varshaansh-git/Team-ReFlex/dp_assm/FINAL_ASSEMBLY.SLDASM

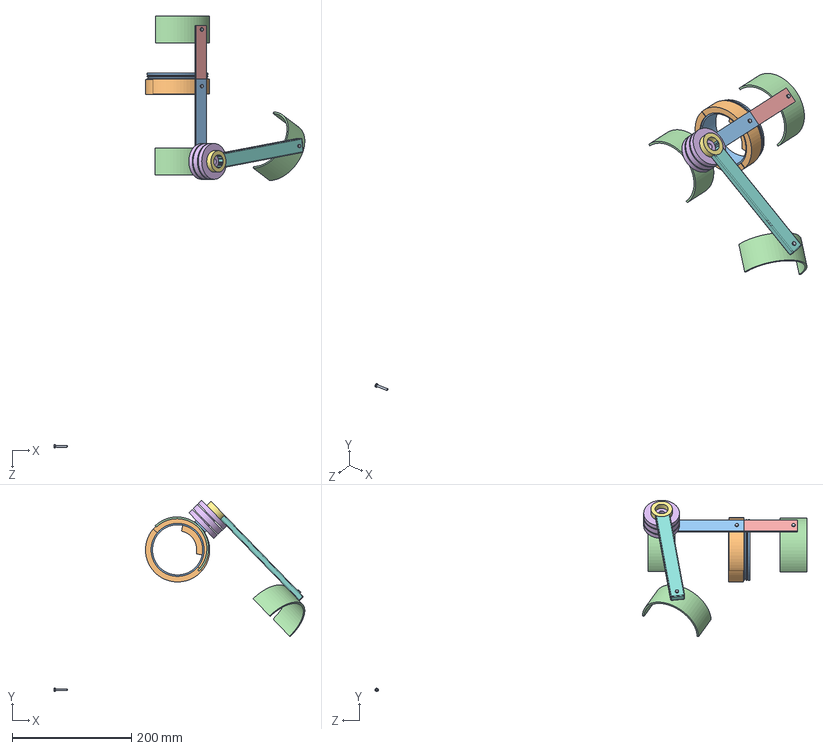
[picture p1: CAD file, 2026-10-25]
dp_assm/FINAL_ASSEMBLY.SLDASM
419.7 x 320.7 x 723.5 mm
inner ring-1 x 2
outer blue ring-1 x 2
rectangle to attach cuff
cuff x 3
rectangle
pulley
005_Fixed elbow bearing housing 1
004_Upper arm lateral rail 1
hex bolt gradeab_iso x 4
cuff2
