varshaansh-git/Team-ReFlex/dp_assm/pulley.SLDPRT

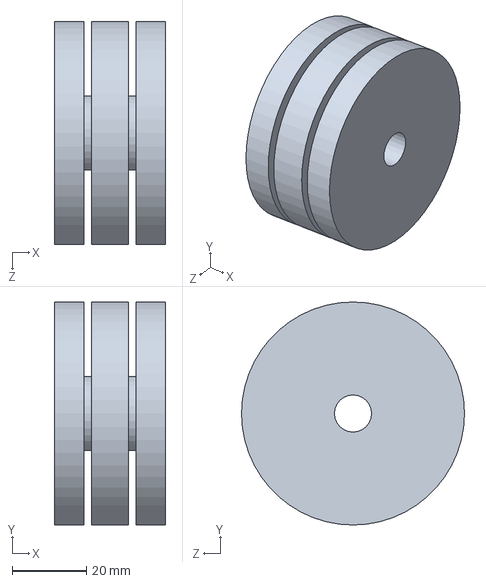
[picture p2: CAD file, 2026-10-25]
dp_assm/pulley.SLDPRT
30.0 x 60.0 x 60.0 mm
