varshaansh-git/Team-ReFlex/dp_assm/rectangle.SLDPRT

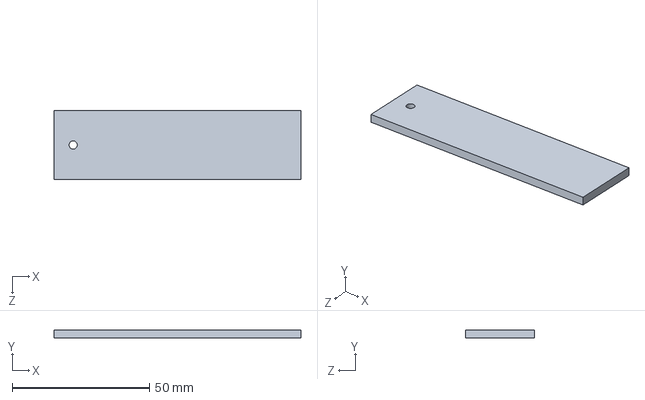
[picture p3: CAD file, 2026-10-25]
dp_assm/rectangle.SLDPRT
90.0 x 3.00 x 25.0 mm
