varshaansh-git/Team-ReFlex/dp_assm/Part1-1.SLDPRT

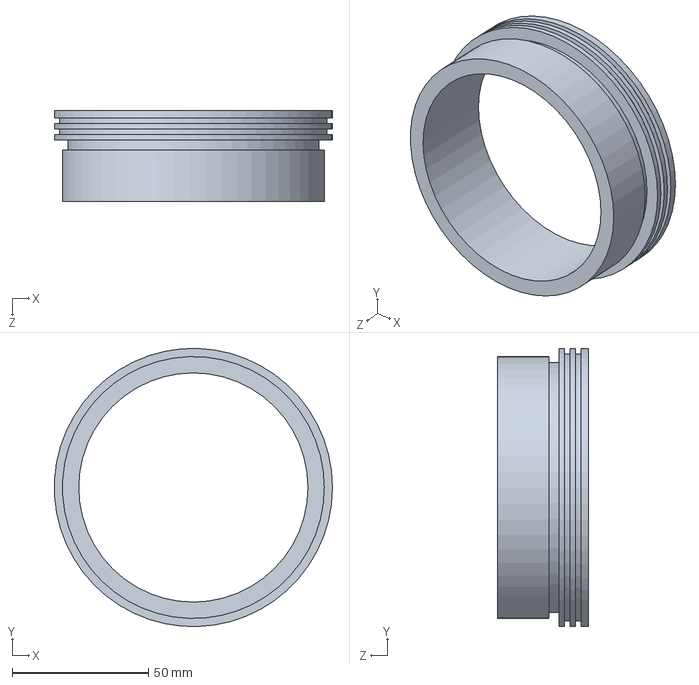
[picture p4: CAD file, 2026-10-25]
dp_assm/Part1-1.SLDPRT
101.9 x 102.0 x 33.5 mm
