varshaansh-git/Team-ReFlex/dp_assm/cuff2.SLDPRT

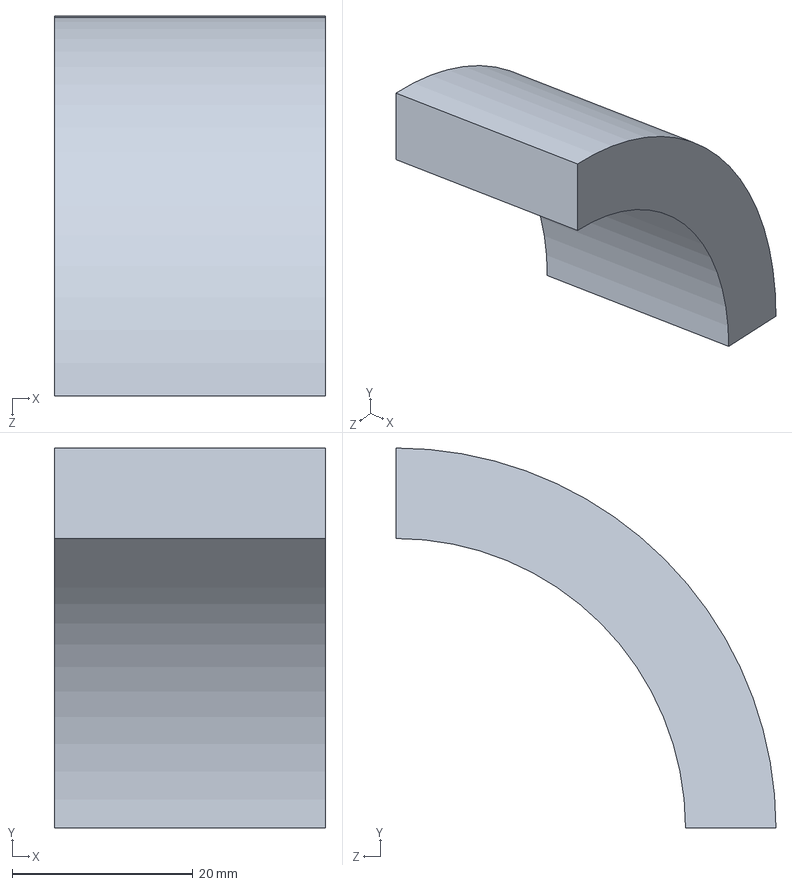
[picture p5: CAD file, 2026-10-25]
dp_assm/cuff2.SLDPRT
30.0 x 42.0 x 42.0 mm
