varshaansh-git/Team-ReFlex/dp_assm/outer blue ring-1.SLDPRT

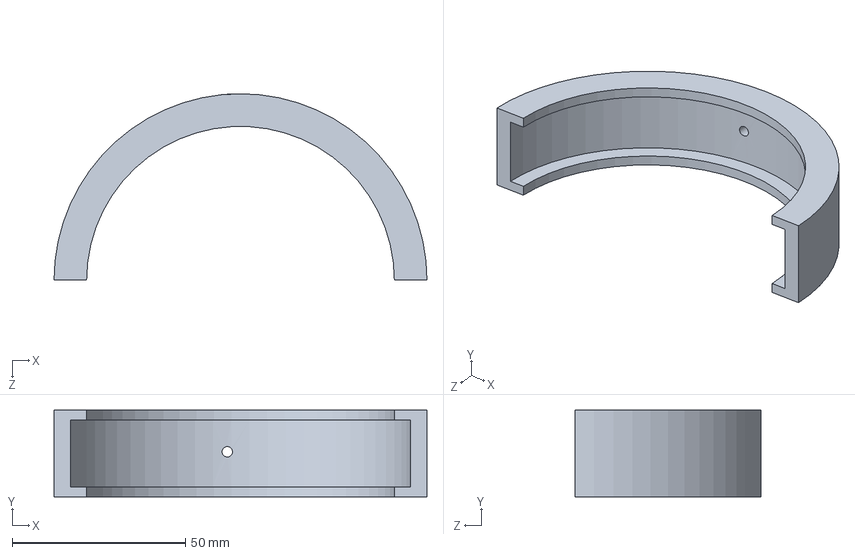
[picture p6: CAD file, 2026-10-25]
dp_assm/outer blue ring-1.SLDPRT
107.6 x 25.0 x 53.8 mm
