varshaansh-git/Team-ReFlex/dp_assm/005_Fixed elbow bearing housing 1.SLDPRT

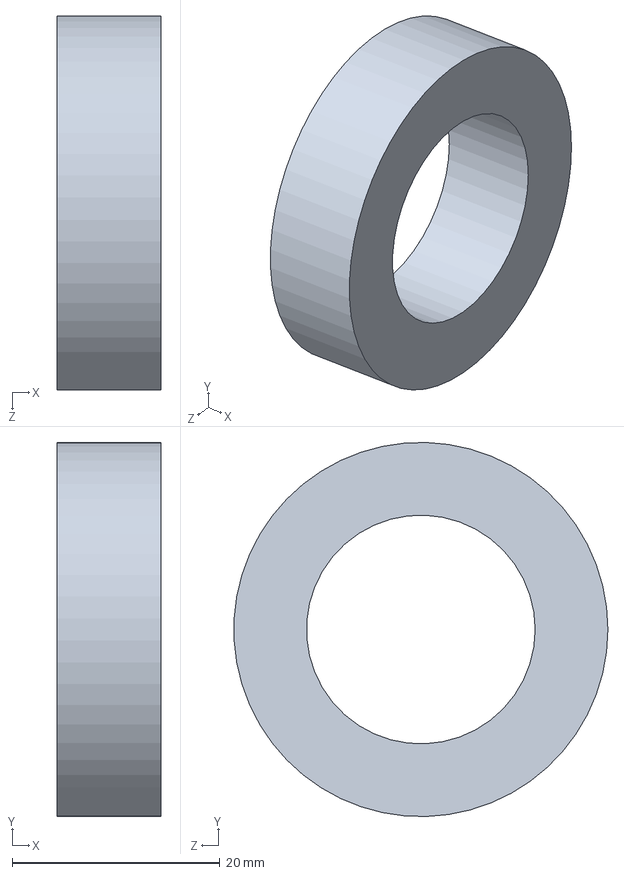
[picture p7: CAD file, 2026-10-25]
dp_assm/005_Fixed elbow bearing housing 1.SLDPRT
10.0 x 36.0 x 36.0 mm
