varshaansh-git/Team-ReFlex/dp_assm/rectangle to attach cuff.SLDPRT

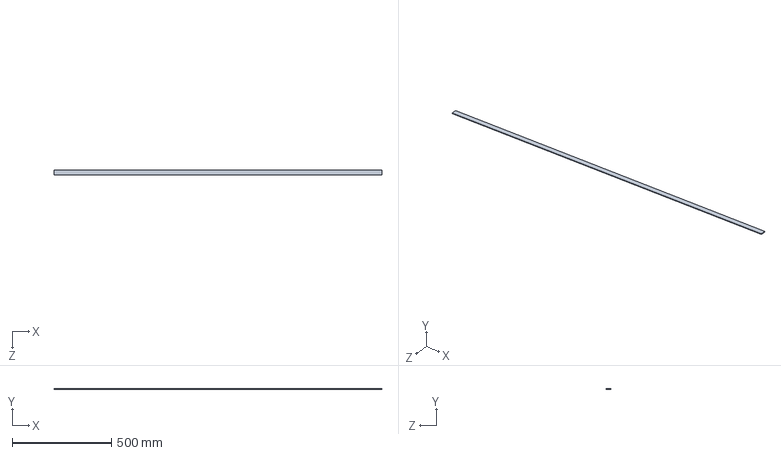
[picture p8: CAD file, 2026-10-25]
dp_assm/rectangle to attach cuff.SLDPRT
1650.0 x 3.00 x 25.0 mm
