varshaansh-git/Team-ReFlex/dp_assm/cuff.SLDPRT

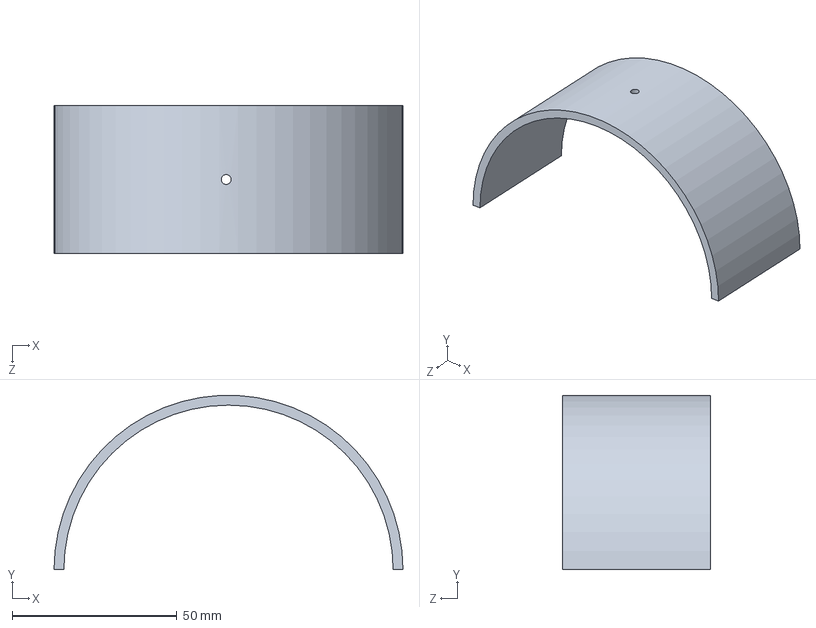
[picture p9: CAD file, 2026-10-25]
dp_assm/cuff.SLDPRT
106.0 x 53.0 x 45.0 mm
