varshaansh-git/Team-ReFlex/dp_assm/004_Upper arm lateral rail 1.SLDPRT

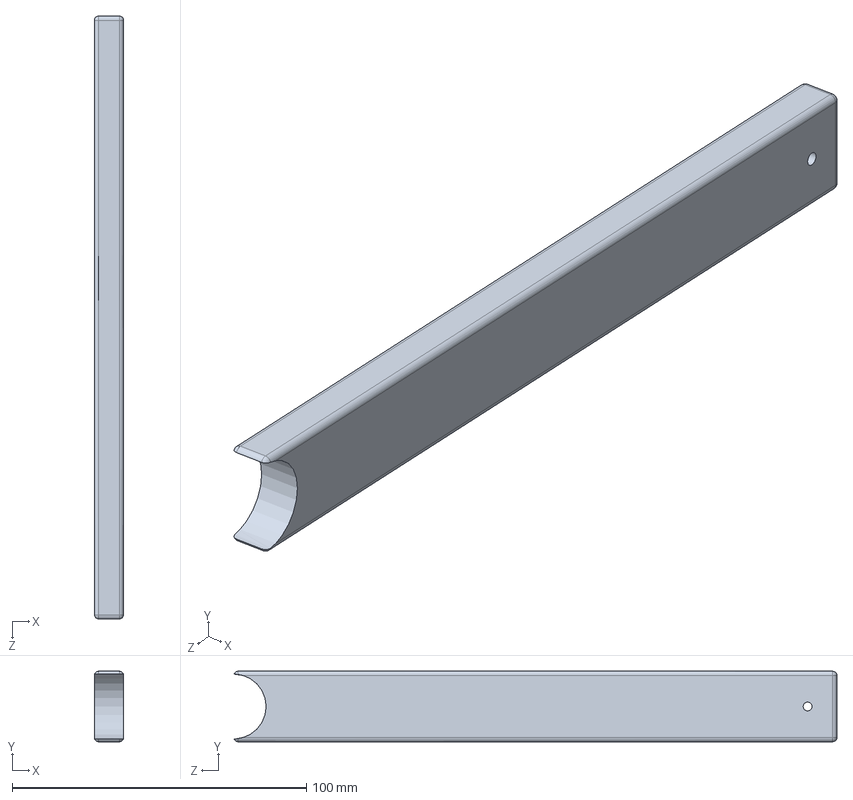
[picture p10: CAD file, 2026-10-25]
dp_assm/004_Upper arm lateral rail 1.SLDPRT
10.0 x 24.0 x 204.9 mm
