varshaansh-git/Team-ReFlex/(list of files, cad)

Other CAD files:
dp_assm/inner ring-1.SLDPRT
